eribertomota/arduino-caixa-dagua/circuito/circuito-eletronico-bitmap.jpg

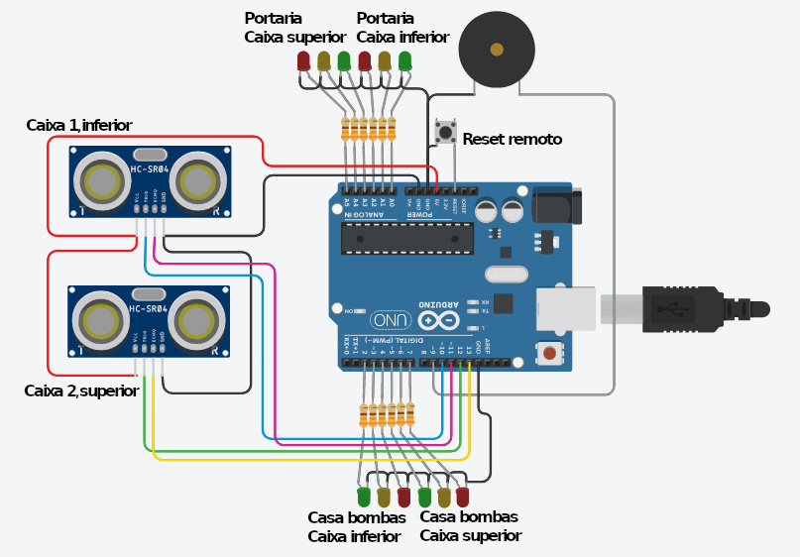
circuito/circuito-eletronico-bitmap.jpg
