eribertomota/arduino-caixa-dagua/FAQ.md

## Perguntas frequentes sobre o Projeto de Monitoramento de Nível de Caixa D'Água

#### Como o projeto começou?
#### Por que medições de 80%, 50% e 30%?
