eribertomota/arduino-caixa-dagua/(commit log)

2021-07-20 Added circuits
2021-07-22 Updated circuit
2021-07-27 Autoformat from Arduino IDE
2021-07-27 Fix double check and improve serial messages
    [arduino-caixa-dagua.ino]
2021-07-30 Fixed percentages and numeric values
    [arduino-caixa-dagua.ino]
2021-07-31 Print tank name
2021-08-02 Fix pin for buzzer in setup
    [arduino-caixa-dagua.ino]
2021-08-11 Fix Pin numbers of the sensor 2
    [arduino-caixa-dagua.ino]
2021-08-11 Fix last tone and add delay
    [arduino-caixa-dagua.ino]
2021-08-26 Fix false positive if box is empty or in very low level
    [arduino-caixa-dagua.ino]
